MITSatellite-Team/mppt-board/mppt-board.kicad_pcb

## KiCad design mppt-board.kicad_pcb (2026-11-12)

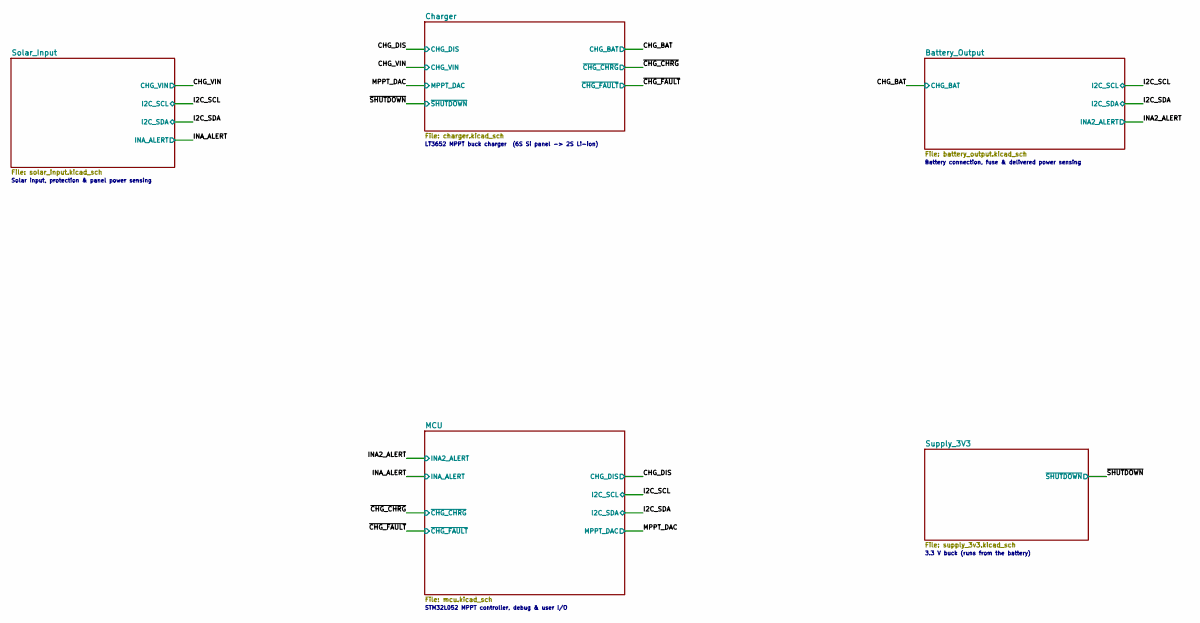
[picture p1: schematic mppt-board.kicad_sch, LEONIRD MPPT test board]

Notes on the sheet:
3.3 V buck (runs from the battery)
Solar input, protection & panel power sensing
STM32L052 MPPT controller, debug & user I/O
Battery connection, fuse & delivered power sensing
LT3652 MPPT buck charger (6S Si panel -> 2S Li-ion)

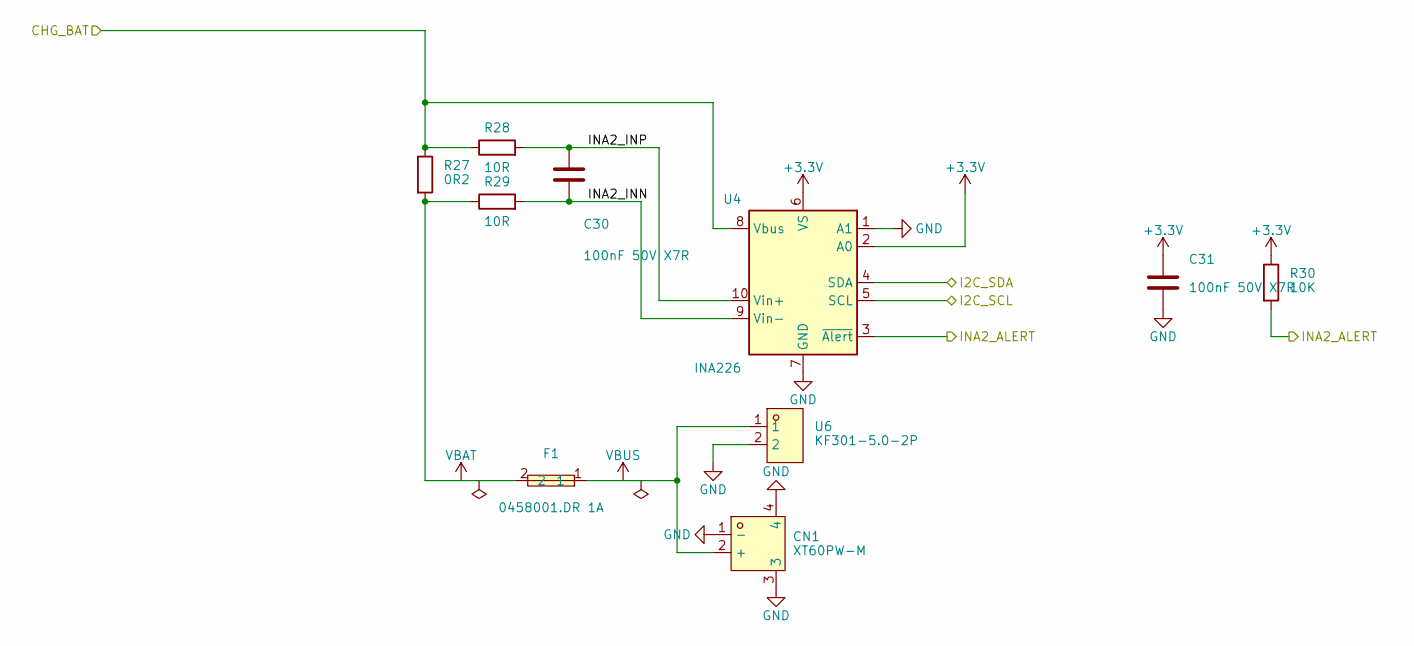
[picture p2: schematic battery_output.kicad_sch, Battery connection, fuse & delivered power sensing]

Parts:
C30, C31: 100nF 50V X7R; C_0603_1608Metric; MPN CC0603KRX7R9BB104; LCSC Part C14663
CN1: XT60PW-M; CONN-TH_XT60PW-M; MPN XT60PW-M; LCSC Part C98732
F1: 0458001.DR 1A; Fuse_1206_3216Metric; MPN 0458001.DR; LCSC Part C187559
R27: 0R2; R_1206_3216Metric; MPN RL12FTNR200; LCSC Part C160920
R28, R29: 10R; R_0603_1608Metric; MPN 0603WAF100JT5E; LCSC Part C22859
R30: 10K; R_0603_1608Metric; MPN 0603WAF1002T5E; LCSC Part C25804
U4: INA226; TSSOP-10_3x3mm_P0.5mm; MPN INA226AIDGSR; LCSC Part C49851
U6: KF301-5.0-2P; CONN-TH_P5.00_KF301-5.0-2P; MPN KF301-5.0-2P; LCSC Part C474881

Connections:
+3.3V: C31.1, R30.1, U4.2 (A0), U4.6 (VS); also elsewhere on the board
/Battery_Output/INA2_INN: C30.2, R29.2, U4.9 (Vin-)
/Battery_Output/INA2_INP: C30.1, R28.2, U4.10 (Vin+)
/CHG_BAT: R27.1, R28.1, U4.8 (Vbus); also elsewhere on the board
/I2C_SCL: U4.5 (SCL); also elsewhere on the board
/I2C_SDA: U4.4 (SDA); also elsewhere on the board
/INA2_ALERT: R30.2, U4.3 (~Alert); also elsewhere on the board
GND: C31.2, CN1.1 (-), CN1.3, CN1.4, U4.1 (A1), U4.7 (GND), U6.2; also elsewhere on the board
VBAT: F1.2, R27.2, R29.1; also elsewhere on the board
VBUS: CN1.2 (+), F1.1, U6.1

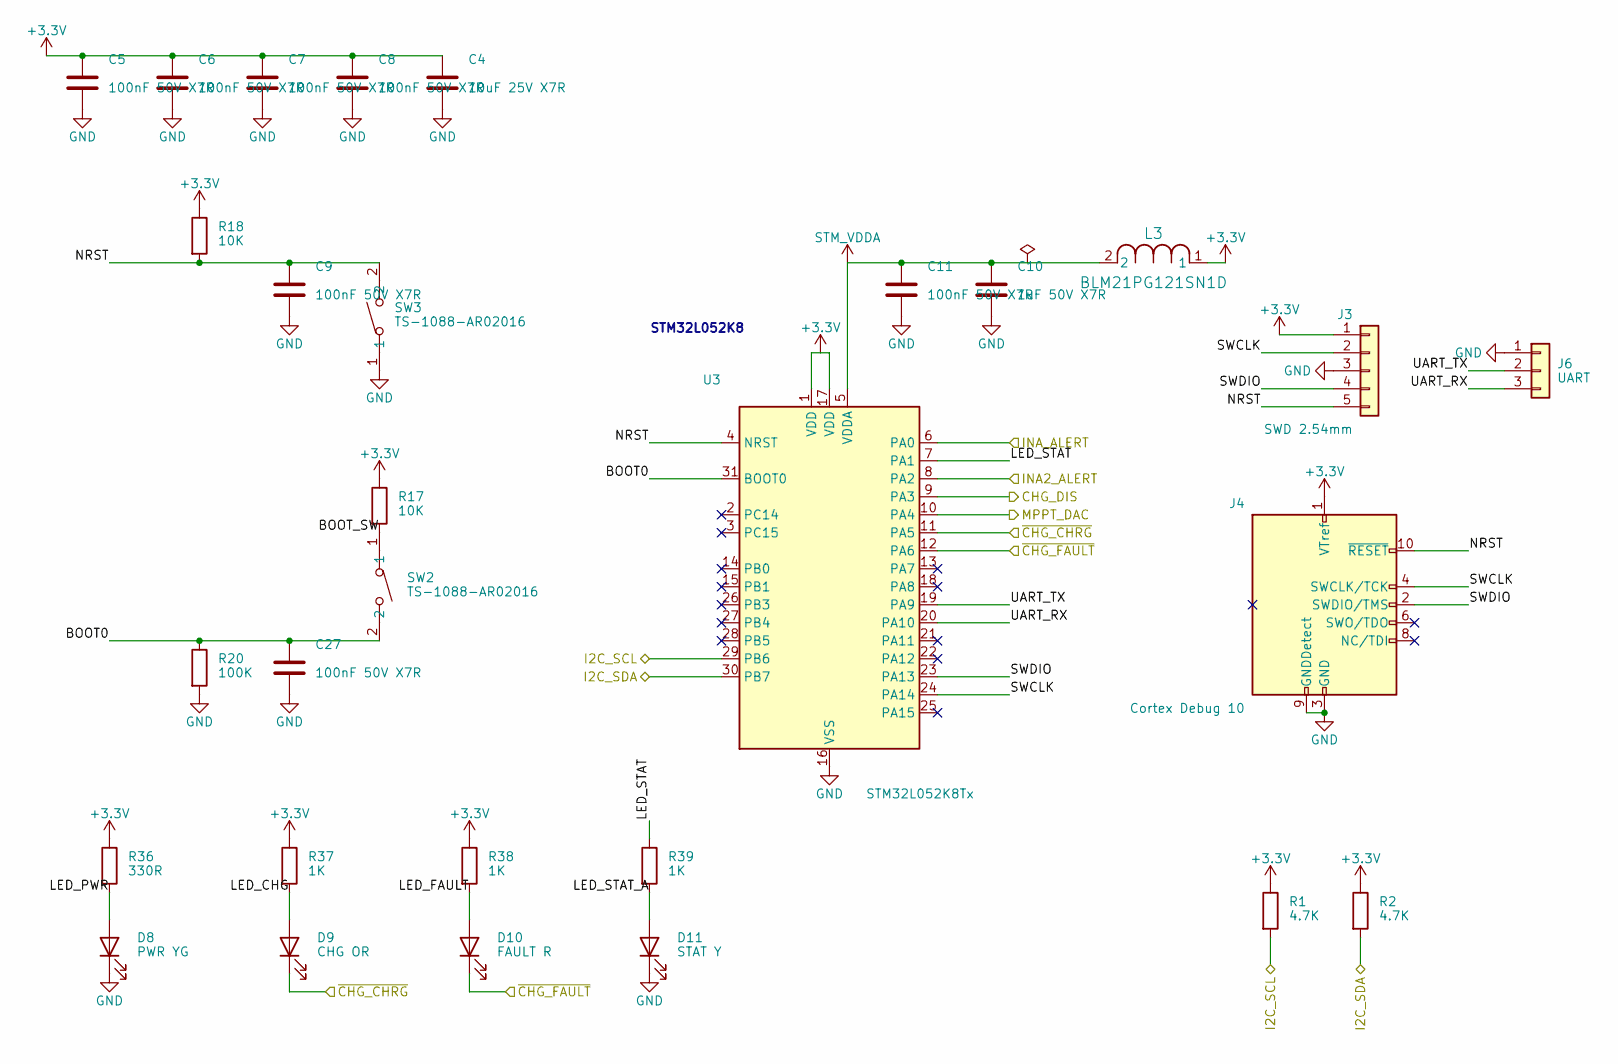
[picture p3: schematic mcu.kicad_sch, STM32L052 MPPT controller, debug & user I/O]

Parts:
C4: 10uF 25V X7R; C_0805_2012Metric; MPN CL21B106KAYQNNE; LCSC Part C3039694
C5, C6, C7, C8, C9, C11, C27: 100nF 50V X7R; C_0603_1608Metric; MPN CC0603KRX7R9BB104; LCSC Part C14663
C10: 1uF 50V X7R; C_0603_1608Metric; MPN CC0603KRX7R9BB105; LCSC Part C559769
D8: PWR YG; LED_0603_1608Metric; MPN XL-1608SYGC-06; LCSC Part C965805
D9: CHG OR; LED_0603_1608Metric; MPN XL-1608UOC-06; LCSC Part C965800
D10: FAULT R; LED_0603_1608Metric; MPN XL-1608SURC-06; LCSC Part C965799
D11: STAT Y; LED_0603_1608Metric; MPN XL-1608UYC-06; LCSC Part C965802
J3: SWD 2.54mm; PinHeader_1x05_P2.54mm_Vertical; MPN HX PZ2.54-1x5P ZZ; LCSC Part C32713271
J4: Cortex Debug 10; PinHeader_2x05_P1.27mm_Vertical_SMD; MPN 20021121-00010C4LF; LCSC Part C150517
J6: UART; PinHeader_1x03_P2.54mm_Vertical; MPN HX PZ2.54-1x3P ZZ; LCSC Part C32713269
L3: BLM21PG121SN1D; IND_25_0805_FRT; MPN BLM21PG121SN1D; LCSC Part C79382
R1, R2: 4.7K; R_0603_1608Metric; MPN 0603WAF4701T5E; LCSC Part C23162
R17, R18: 10K; R_0603_1608Metric; MPN 0603WAF1002T5E; LCSC Part C25804
R20: 100K; R_0603_1608Metric; MPN 0603WAF1003T5E; LCSC Part C25803
R36: 330R; R_0603_1608Metric; MPN 0603WAF3300T5E; LCSC Part C23138
R37, R38, R39: 1K; R_0603_1608Metric; MPN 0603WAF1001T5E; LCSC Part C21190
SW2, SW3: TS-1088-AR02016; SW-SMD_L3.9-W3.0-P4.45; MPN TS-1088-AR02016; LCSC Part C720477
U3: STM32L052K8Tx; LQFP-32_7x7mm_P0.8mm; MPN STM32L052K8T6; LCSC Part C222404

Connections:
+3.3V: C4.1, C5.1, C6.1, C7.1, C8.1, J3.1, J4.1 (VTref), L3.1, R1.1, R2.1, R17.1, R18.1, R36.1, R37.1, R38.1, U3.1 (VDD), U3.17 (VDD); also elsewhere on the board
/CHG_DIS: U3.9 (PA3); also elsewhere on the board
/I2C_SCL: R1.2, U3.29 (PB6); also elsewhere on the board
/I2C_SDA: R2.2, U3.30 (PB7); also elsewhere on the board
/INA2_ALERT: U3.8 (PA2); also elsewhere on the board
/INA_ALERT: U3.6 (PA0); also elsewhere on the board
/MCU/BOOT0: C27.1, R20.1, SW2.2, U3.31 (BOOT0)
/MCU/BOOT_SW: R17.2, SW2.1
/MCU/LED_CHG: D9.2 (A), R37.2
/MCU/LED_FAULT: D10.2 (A), R38.2
/MCU/LED_PWR: D8.2 (A), R36.2
/MCU/LED_STAT: R39.1, U3.7 (PA1)
/MCU/LED_STAT_A: D11.2 (A), R39.2
/MCU/NRST: C9.1, J3.5, J4.10 (~RESET), R18.2, SW3.2, U3.4 (NRST)
/MCU/SWCLK: J3.2, J4.4 (SWCLK/TCK), U3.24 (PA14)
/MCU/SWDIO: J3.4, J4.2 (SWDIO/TMS), U3.23 (PA13)
/MCU/UART_RX: J6.3, U3.20 (PA10)
/MCU/UART_TX: J6.2, U3.19 (PA9)
/MPPT_DAC: U3.10 (PA4); also elsewhere on the board
/~CHG_CHRG: D9.1 (K), U3.11 (PA5); also elsewhere on the board
/~CHG_FAULT: D10.1 (K), U3.12 (PA6); also elsewhere on the board
GND: C4.2, C5.2, C6.2, C7.2, C8.2, C9.2, C10.2, C11.2, C27.2, D8.1 (K), D11.1 (K), J3.3, J4.3 (GND), J4.5 (GND), J4.9 (GNDDetect), J6.1, R20.2, SW3.1, U3.16 (VSS), U3.32 (VSS); also elsewhere on the board
STM_VDDA: C10.1, C11.1, L3.2, U3.5 (VDDA)

Notes on the sheet:
STM32L052K8

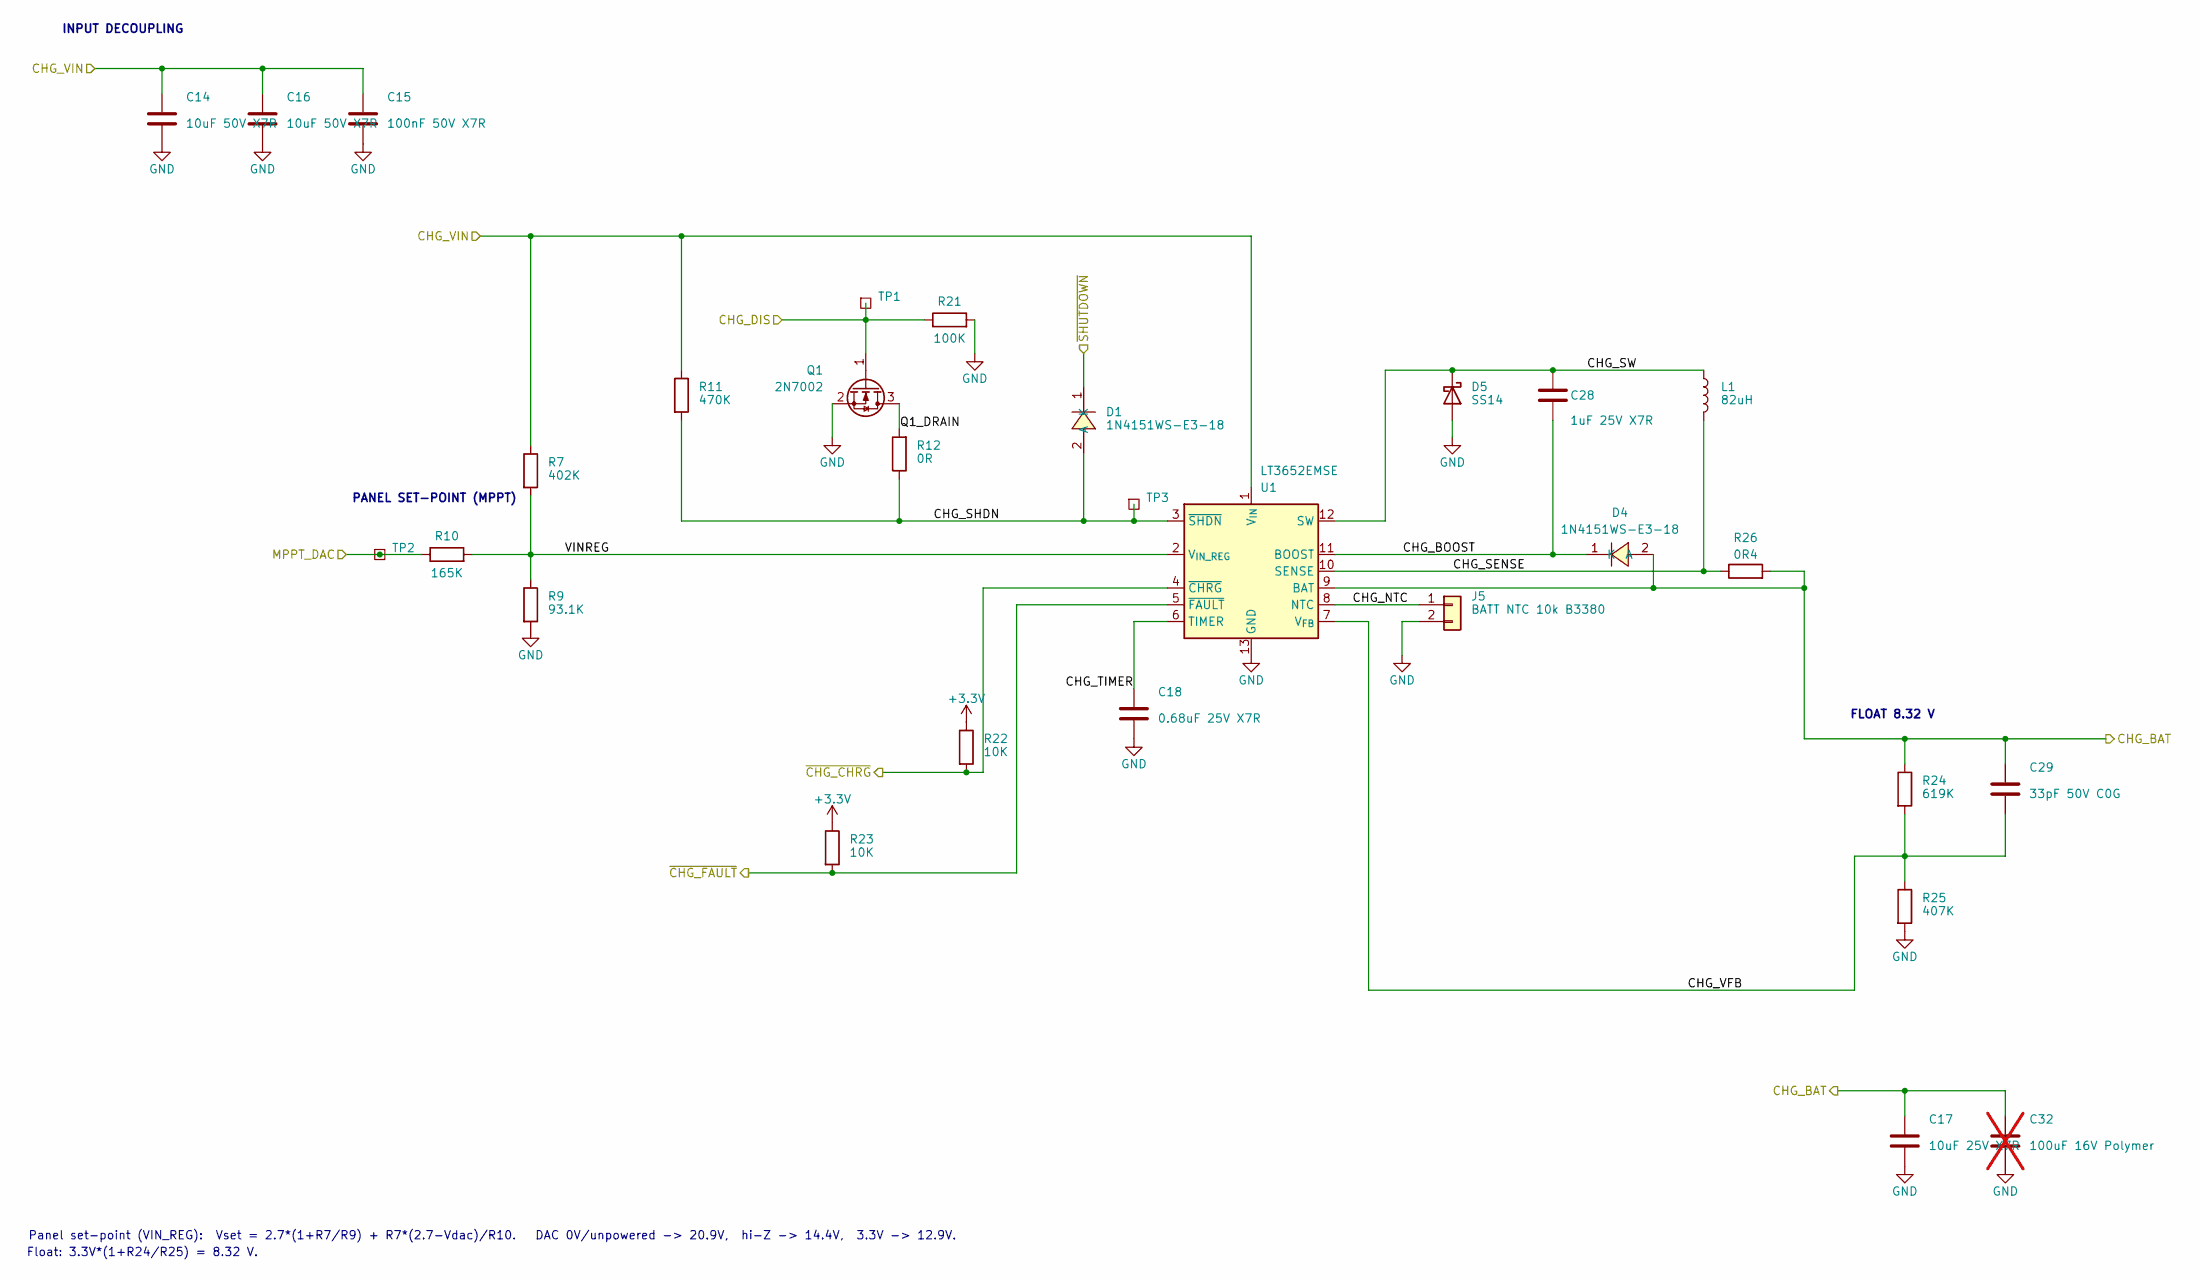
[picture p4: schematic charger.kicad_sch, LT3652 MPPT buck charger (6S Si panel -> 2S Li-ion)]

Parts:
C14, C16: 10uF 50V X7R; C_1206_3216Metric; MPN CL31B106KBHNNNE; LCSC Part C89632
C15: 100nF 50V X7R; C_0603_1608Metric; MPN CC0603KRX7R9BB104; LCSC Part C14663
C17: 10uF 25V X7R; C_0805_2012Metric; MPN CL21B106KAYQNNE; LCSC Part C3039694
C18: 0.68uF 25V X7R; C_0603_1608Metric; MPN CC0603KRX7R8BB684; LCSC Part C2838708
C28: 1uF 25V X7R; C_0603_1608Metric; MPN CL10B105KA8NNNC; LCSC Part C29936
C29: 33pF 50V C0G; C_0603_1608Metric; MPN CL10C330JB8NNNC; LCSC Part C1663
C32: 100uF 16V Polymer; CP_EIA-7343-31_Kemet-D; MPN 16TQC100MYF; LCSC Part C109085; not fitted
D1, D4: 1N4151WS-E3-18; SOD-323_L1.8-W1.3-LS2.7-RD; MPN 1N4151WS-E3-18; LCSC Part C17429783
D5: SS14; D_SMA; MPN SS14; LCSC Part C2480
J5: BATT NTC 10k B3380; PinHeader_1x02_P2.54mm_Vertical; MPN HX PZ2.54-1x2P ZZ; LCSC Part C32713268
L1: 82uH; L_Changjiang_FNR6045S; MPN FNR6045S820MT; LCSC Part C168093
Q1: 2N7002; SOT-23; MPN 2N7002; LCSC Part C8545
R7: 402K; R_0603_1608Metric; MPN 0603WAF4023T5E; LCSC Part C23048
R9: 93.1K; R_0603_1608Metric; MPN 0603WAF9312T5E; LCSC Part C23266
R10: 165K; R_0603_1608Metric; MPN 0603WAF1653T5E; LCSC Part C22816
R11: 470K; R_0603_1608Metric; MPN 0603WAF4703T5E; LCSC Part C23178
R12: 0R; R_0603_1608Metric; MPN 0603WAF0000T5E; LCSC Part C21189
R21: 100K; R_0603_1608Metric; MPN 0603WAF1003T5E; LCSC Part C25803
R22, R23: 10K; R_0603_1608Metric; MPN 0603WAF1002T5E; LCSC Part C25804
R24: 619K; R_0603_1608Metric; MPN RT0603BRD07619KL; LCSC Part C861497
R25: 407K; R_0603_1608Metric; MPN RT0603BRD07407KL; LCSC Part C861390
R26: 0R4; R_0805_2012Metric; MPN FRL0805FR400TS; LCSC Part C2934266
TP1: CHG_DIS; TestPoint_Pad_1.5x1.5mm
TP2: MPPT_DAC; TestPoint_Pad_1.5x1.5mm
TP3: CHG_SHDN; TestPoint_Pad_1.5x1.5mm
U1: LT3652EMSE; MSOP-12-1EP_3x4.039mm_P0.65mm_EP1.651x2.845mm_ThermalVias; MPN LT3652EMSE#PBF; LCSC Part C580114

Connections:
+3.3V: R22.1, R23.1; also elsewhere on the board
/CHG_BAT: C17.1, C29.1, C32.1, D4.2 (A), R24.1, R26.2, U1.9 (BAT); also elsewhere on the board
/CHG_DIS: Q1.1 (G), R21.1, TP1.1 (1_1); also elsewhere on the board
/CHG_VIN: C14.1, C15.1, C16.1, R7.1, R11.1, U1.1 (V_{IN}); also elsewhere on the board
/Charger/CHG_BOOST: C28.1, D4.1 (K), U1.11 (BOOST)
/Charger/CHG_NTC: J5.1, U1.8 (NTC)
/Charger/CHG_SENSE: L1.2, R26.1, U1.10 (SENSE)
/Charger/CHG_SHDN: D1.2 (A), R11.2, R12.1, TP3.1 (1_1), U1.3 (~SHDN)
/Charger/CHG_SW: C28.2, D5.1 (K), L1.1, U1.12 (SW)
/Charger/CHG_TIMER: C18.1, U1.6 (TIMER)
/Charger/CHG_VFB: C29.2, R24.2, R25.1, U1.7 (V_{FB})
/Charger/Q1_DRAIN: Q1.3 (D), R12.2
/Charger/VINREG: R7.2, R9.1, R10.2, U1.2 (V_{IN_REG})
/MPPT_DAC: R10.1, TP2.1 (1_1); also elsewhere on the board
/~CHG_CHRG: R22.2, U1.4 (~CHRG); also elsewhere on the board
/~CHG_FAULT: R23.2, U1.5 (~FAULT); also elsewhere on the board
/~SHUTDOWN: D1.1 (K); also elsewhere on the board
GND: C14.2, C15.2, C16.2, C17.2, C18.2, C32.2, D5.2 (A), J5.2, Q1.2 (S), R9.2, R21.2, R25.2, U1.13 (GND); also elsewhere on the board

Notes on the sheet:
PANEL SET-POINT (MPPT)
Panel set-point (VIN_REG): Vset = 2.7*(1+R7/R9) + R7*(2.7-Vdac)/R10. DAC 0V/unpowered -> 20.9V, hi-Z -> 14.4V, 3.3V -> 12.9V.
INPUT DECOUPLING
Float: 3.3V*(1+R24/R25) = 8.32 V.
FLOAT 8.32 V

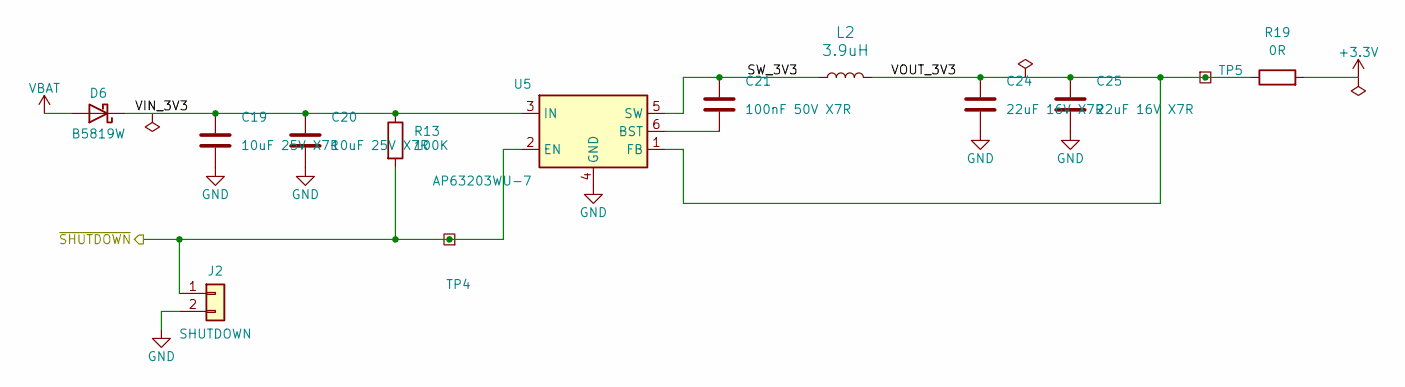
[picture p5: schematic supply_3v3.kicad_sch, 3.3 V buck-boost (runs from the battery or USB)]

Parts:
C19, C20: 10uF 25V X7R; C_0805_2012Metric; MPN CL21B106KAYQNNE; LCSC Part C3039694
C21: 100nF 50V X7R; C_0603_1608Metric; MPN CC0603KRX7R9BB104; LCSC Part C14663
C24, C25: 22uF 16V X7R; C_1206_3216Metric; MPN CS3216X7R226K160NRI; LCSC Part C5252682
D6: B5819W; D_SOD-123; MPN B5819W SL; LCSC Part C8598
J2: SHUTDOWN; PinHeader_1x02_P2.54mm_Vertical; MPN HX PZ2.54-1x2P ZZ; LCSC Part C32713268
L2: 3.9uH; L_Sunlord_SWPA4030S; MPN SWPA4030S3R9MT; LCSC Part C96899
R13: 100K; R_0603_1608Metric; MPN 0603WAF1003T5E; LCSC Part C25803
R19: 0R; R_0805_2012Metric; MPN 0805W8F0000T5E; LCSC Part C17477
TP4, TP5: TestPoint_Square; TestPoint_Pad_2.5x2.5mm
U5: AP63203WU-7; TSOT-23-6; MPN AP63203WU-7; LCSC Part C780769

Connections:
+3.3V: R19.2; also elsewhere on the board
/Supply_3V3/SW_3V3: C21.1, L2.1, U5.5 (SW)
/Supply_3V3/VIN_3V3: C19.1, C20.1, D6.1 (K), R13.1, U5.3 (IN)
/Supply_3V3/VOUT_3V3: C24.1, C25.1, L2.2, R19.1, TP5.1 (1_1), U5.1 (FB)
/~SHUTDOWN: J2.1, R13.2, TP4.1 (1_1), U5.2 (EN); also elsewhere on the board
GND: C19.2, C20.2, C24.2, C25.2, J2.2, U5.4 (GND); also elsewhere on the board
unnamed: C21.2, U5.6 (BST)
VBAT: D6.2 (A); also elsewhere on the board

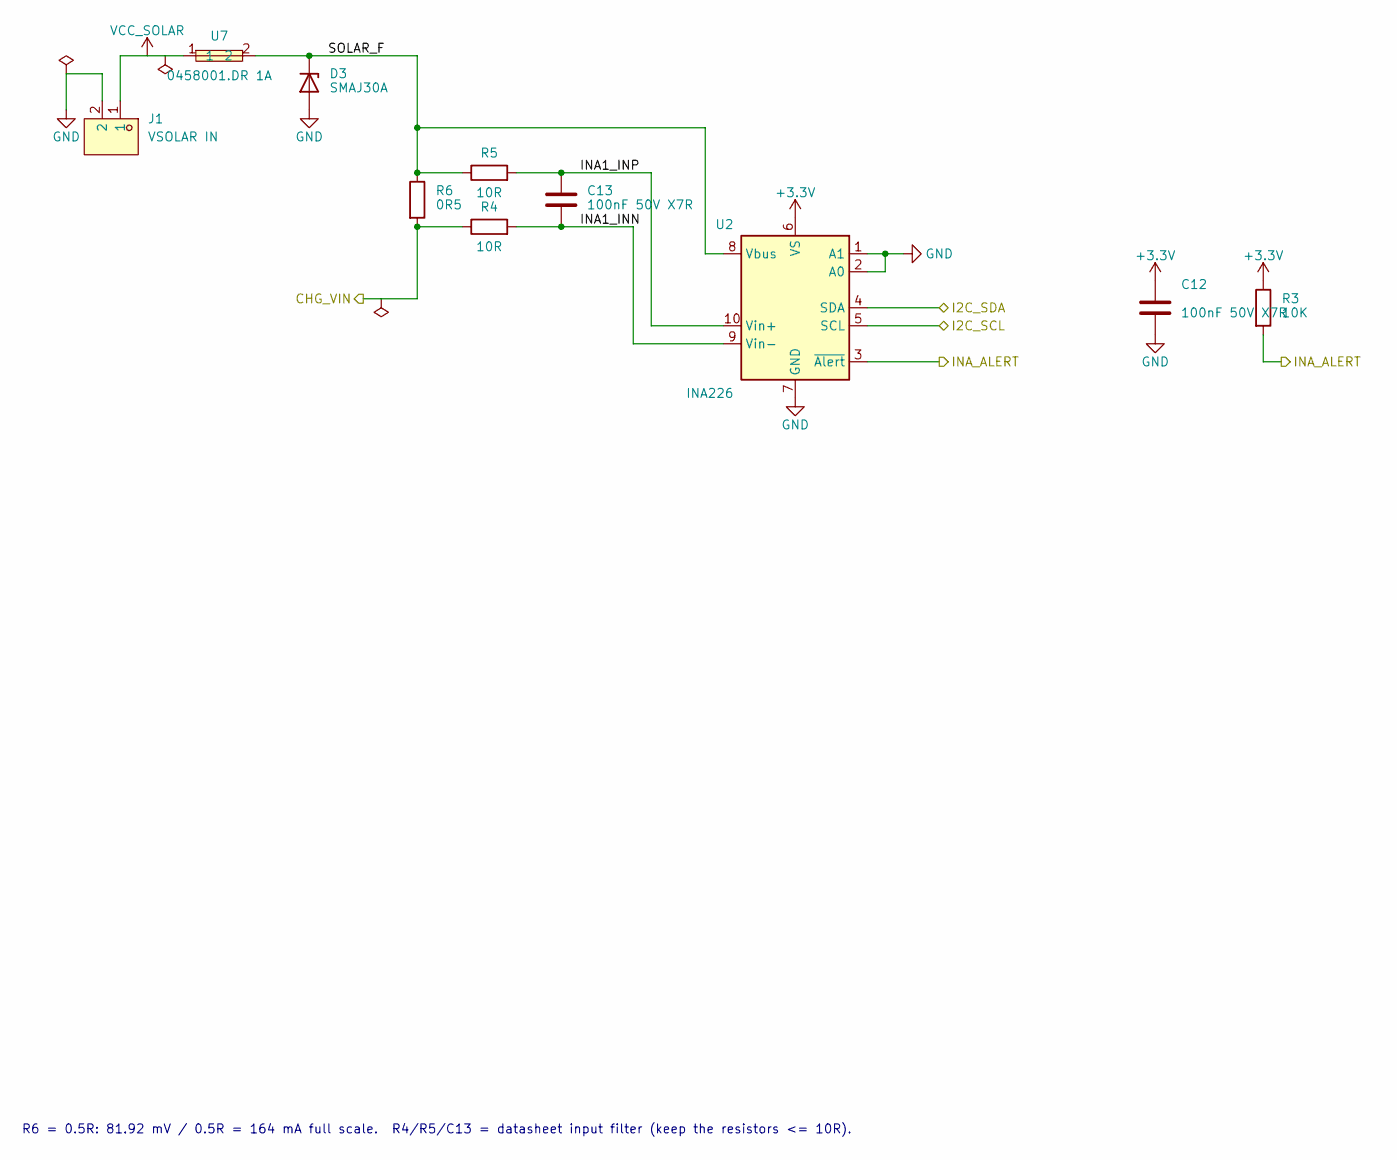
[picture p6: schematic solar_input.kicad_sch, Solar input, protection & panel power sensing]

Parts:
C12, C13: 100nF 50V X7R; C_0603_1608Metric; MPN CC0603KRX7R9BB104; LCSC Part C14663
D3: SMAJ30A; D_SMA; MPN SMAJ30A; LCSC Part C148230
J1: VSOLAR IN; CONN-TH_P5.00_KF301-5.0-2P; MPN KF301-5.0-2P; LCSC Part C474881
R3: 10K; R_0603_1608Metric; MPN 0603WAF1002T5E; LCSC Part C25804
R4, R5: 10R; R_0603_1608Metric; MPN 0603WAF100JT5E; LCSC Part C22859
R6: 0R5; R_1206_3216Metric; MPN CSR1206FTR500; LCSC Part C346764
U2: INA226; TSSOP-10_3x3mm_P0.5mm; MPN INA226AIDGSR; LCSC Part C49851
U7: 0458001.DR 1A; Fuse_1206_3216Metric; MPN 0458001.DR; LCSC Part C187559

Connections:
+3.3V: C12.1, R3.1, U2.6 (VS); also elsewhere on the board
/CHG_VIN: R4.1, R6.2; also elsewhere on the board
/I2C_SCL: U2.5 (SCL); also elsewhere on the board
/I2C_SDA: U2.4 (SDA); also elsewhere on the board
/INA_ALERT: R3.2, U2.3 (~Alert); also elsewhere on the board
/Solar_Input/INA1_INN: C13.2, R4.2, U2.9 (Vin-)
/Solar_Input/INA1_INP: C13.1, R5.2, U2.10 (Vin+)
/Solar_Input/SOLAR_F: D3.1 (K), R5.1, R6.1, U2.8 (Vbus), U7.2
GND: C12.2, D3.2 (A), J1.2, U2.1 (A1), U2.2 (A0), U2.7 (GND); also elsewhere on the board
VCC_SOLAR: J1.1, U7.1

Notes on the sheet:
R6 = 0.5R: 81.92 mV / 0.5R = 164 mA full scale. R4/R5/C13 = datasheet input filter (keep the resistors <= 10R).

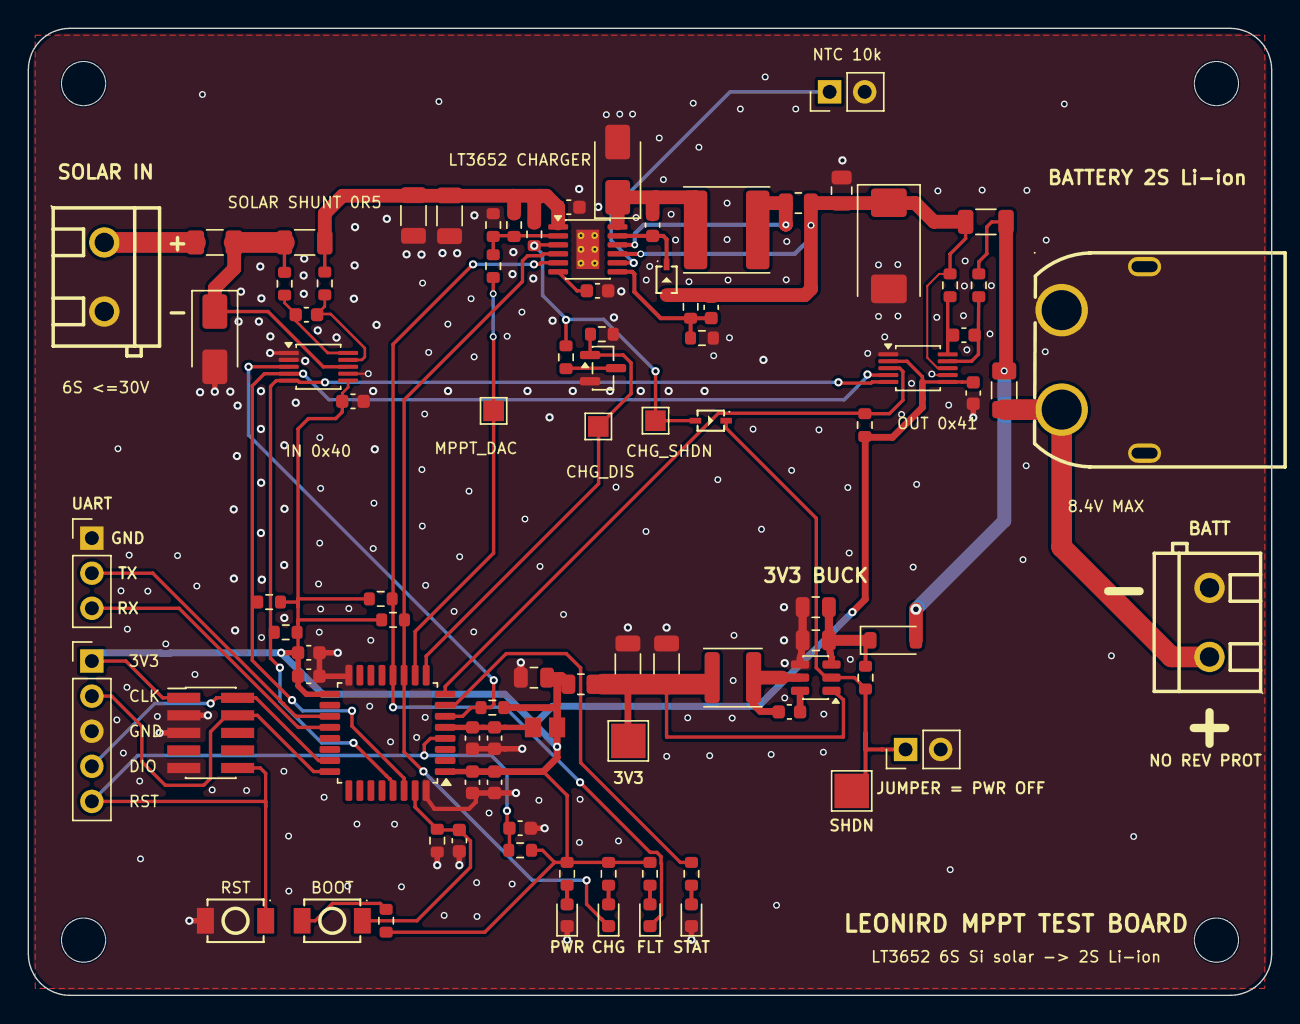
[picture p7: board mppt-board.kicad_pcb from above]

Board: 4 copper layers, 90.0 x 70.0 mm, 95 parts (0 on the bottom side), 47 nets.

Other parts of the board:
H1, H2, H3, H4: M3; MountingHole_3.2mm_M3
