MITSatellite-Team/mppt-board/(commit log)

2026-11-03 ADD STUFF
    [mppt-board.kicad_pcb, mppt-board.kicad_sch]
2026-11-09 board finished
    [battery_output.kicad_sch, charger.kicad_sch, mcu.kicad_sch, mppt-board.kicad_pcb, mppt-board.kicad_sch, solar_input.kicad_sch, supply_3v3.kicad_sch, usb_uart.kicad_sch]
2026-11-11 made updates from review tips
    [battery_output.kicad_sch, charger.kicad_sch, mcu.kicad_sch, mppt-board.kicad_pcb, mppt-board.kicad_sch, solar_input.kicad_sch, supply_3v3.kicad_sch, usb_uart.kicad_sch]
2026-11-12 small fixes
    [mppt-board.kicad_pcb]
